SecretKr/NAV-Cansat-2021/Presentation/gui.PNG

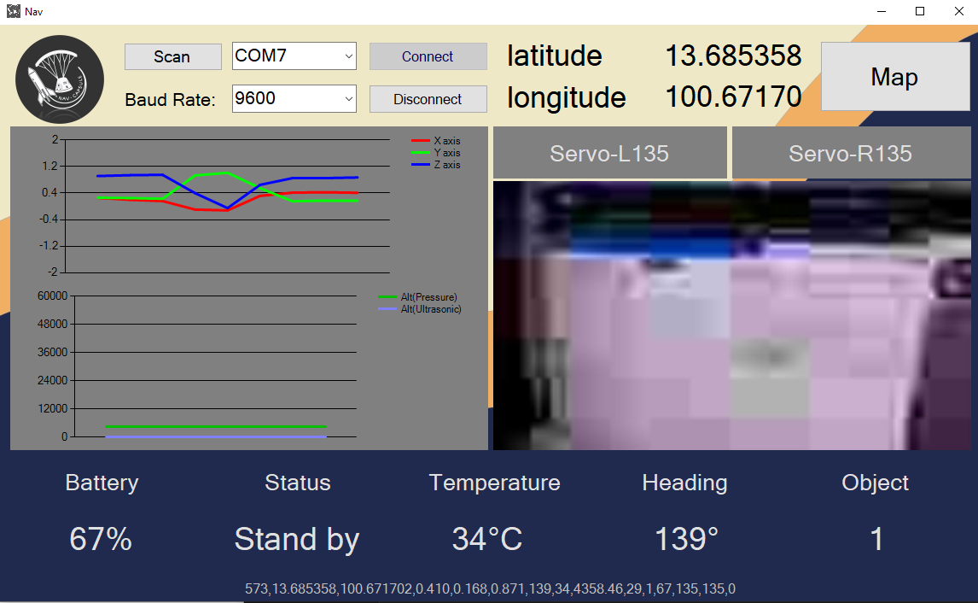
Presentation/gui.PNG
