SecretKr/NAV-Cansat-2021/Cansat/pi install.txt

sudo apt-get update
sudo apt-get upgrade
sudo apt install samba samba-common-bin smbclient cifs-utils
sudo nano /etc/samba/smb.conf
	[pimylifeupshare]
	path = /home/pi/shared
	writeable=Yes
	create mask=0777
	directory mask=0777
	public=no
sudo apt-get install xrdp
