SecretKr/NAV-Cansat-2021/Rocket/test/test1.xlsx

Millis | T | AX | AY | AZ | Vec | ReMPU | wire | Temp | Press | Alt
0 | 0 | 0.91 | -0.32 | -0.35 | 1.03 | 0 | 1 | 35.83 | 1006.09 | 112.9_x0001_" | _x0002__x0010__x0005_Ó_x0001__x0002_!Û_x0004_û_x0005_Ó
0 | 0 | 0.89 | -0.34 | -0.37 | 1.02 | 0 | 0 | 35.83 | 1006.09 | 112.92 | 1.67 | -1.23 | 0.01
0 | 0 | 0.94 | -0.29 | -0.32 | 1.04 | 0 | 1 | 35.83 | 1006.09 | 112.91 | 0.33 | 0.54 | 0.01
0 | 1 | 0.91 | -0.31 | -0.34 | 1.01 | 0 | 1 | 35.83 | 1006.09 | 112.91 | 0.88 | 0.54 | 0.01
0 | 2 | 0.92 | -0.31 | -0.32 | 1.02 | 0 | 1 | 35.83 | 1006.09 | 112.91 | 3.99 | -1.47 | 0.01
0 | 3 | 0.89 | -0.32 | -0.38 | 1.02 | 0 | 1 | 35.83 | 1006.09 | 112.91 | 0.08 | -0.01 | 0.08
0 | 4 | 0.91 | -0.32 | -0.36 | 1.03 | 0 | 1 | 35.83 | 1006.09 | 112.91 | 1.18 | -0.01 | 0.08
0 | 5 | 0.91 | -0.32 | -0.32 | 1.02 | 0 | 1 | 35.83 | 1006.09 | 112.91 | 1 | 0.24 | 0.08
0 | 6 | 0.91 | -0.32 | -0.35 | 1.03 | 0 | 1 | 35.83 | 1006.09 | 112.88 | 0.45 | 0.11 | 0.01
0 | 7 | 0.91 | -0.32 | -0.35 | 1.03 | 0 | 1 | 35.83 | 1006.09 | 112.88 | 0.02 | -0.01 | 0.01
0 | 8 | 0.9 | -0.31 | -0.35 | 1.02 | 0 | 1 | 35.83 | 1006.09 | 112.88 | 2.09 | -0.56 | -0._x0005__x0008_
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
