SecretKr/NAV-Cansat-2021/Rocket/rocket smb.brd

## EAGLE design Rocket/rocket smb.brd (2022-01-02)

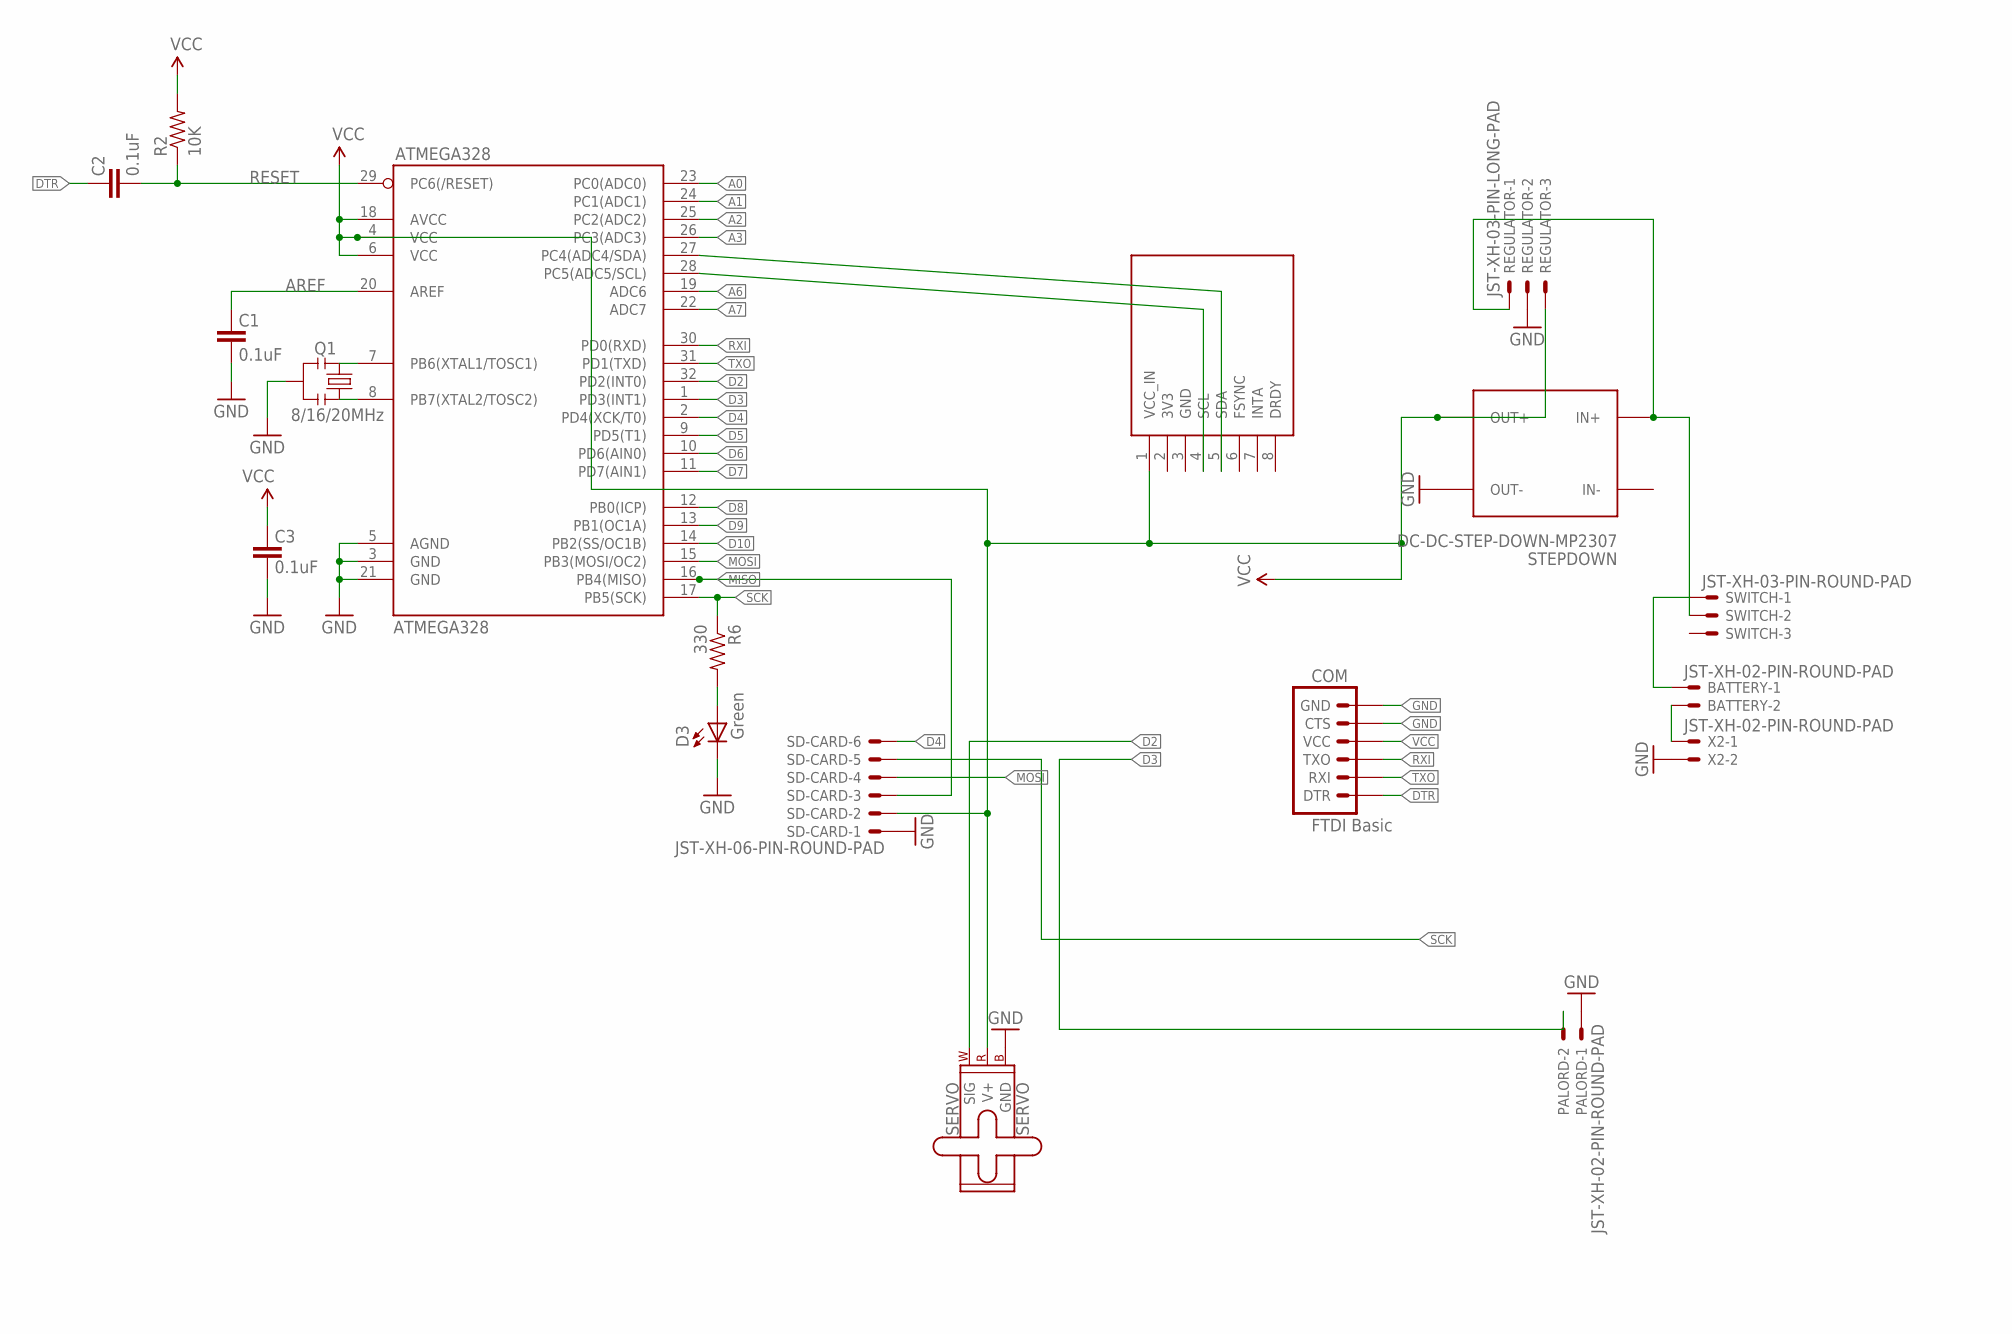
[picture p2: schematic rocket smb.sch]

Parts:
ATMEGA328: ATMEGA328; TQFP32-08
BATTERY: JST-XH-02-PIN-ROUND-PAD; JST-XH-02-PACKAGE-ROUND-PAD
C1, C2, C3: 0.1uF; 0603-CAP
COM: FTDI Basic; 1X06
D3: Green; 0603-LED-ALT1
MPU: GY-86
PALORD: JST-XH-02-PIN-ROUND-PAD; JST-XH-02-PACKAGE-ROUND-PAD
Q1: 8/16/20MHz; RESONATOR-SMD-1:1
R2: 10K; 0603-RES
R6: 330; 0603-RES
REGULATOR: JST-XH-03-PIN-LONG-PAD; JST-XH-03-PACKAGE-LONG-PAD
SD-CARD: JST-XH-06-PIN-ROUND-PAD; JST-XH-06-PACKAGE-ROUND-PAD
SERVO: SERVO; 1X03
STEPDOWN: DC-DC-STEP-DOWN-MP2307
SWITCH: JST-XH-03-PIN-ROUND-PAD; JST-XH-03-PACKAGE-ROUND-PAD
X2: JST-XH-02-PIN-ROUND-PAD; JST-XH-02-PACKAGE-ROUND-PAD

Connections:
A0: ATMEGA328.23 (PC0(ADC0))
A1: ATMEGA328.24 (PC1(ADC1))
A2: ATMEGA328.25 (PC2(ADC2))
A3: ATMEGA328.26 (PC3(ADC3))
A6: ATMEGA328.19 (ADC6)
A7: ATMEGA328.22 (ADC7)
AREF: ATMEGA328.20 (AREF), C1.2
D2: ATMEGA328.32 (PD2(INT0)), SERVO.1 (SIG)
D3: ATMEGA328.1 (PD3(INT1)), PALORD.2
D4: ATMEGA328.2 (PD4(XCK/T0)), SD-CARD.6
D5: ATMEGA328.9 (PD5(T1))
D6: ATMEGA328.10 (PD6(AIN0))
D7: ATMEGA328.11 (PD7(AIN1))
D8: ATMEGA328.12 (PB0(ICP))
D9: ATMEGA328.13 (PB1(OC1A))
D10: ATMEGA328.14 (PB2(SS/OC1B))
DTR: C2.2, COM.1 (DTR)
GND: ATMEGA328.3 (GND), ATMEGA328.5 (AGND), ATMEGA328.21 (GND), C1.1, C3.1, COM.5 (CTS), COM.6 (GND), D3.C, MPU.3 (GND), PALORD.1, Q1.2, REGULATOR.2, SD-CARD.1, SERVO.3 (GND), STEPDOWN.OUT-, X2.2
MISO: ATMEGA328.16 (PB4(MISO)), SD-CARD.3
MOSI: ATMEGA328.15 (PB3(MOSI/OC2)), SD-CARD.4
unnamed: BATTERY.2, X2.1
unnamed: BATTERY.1, SWITCH.1
unnamed: REGULATOR.1, STEPDOWN.IN+, SWITCH.2
unnamed: ATMEGA328.28 (PC5(ADC5/SCL)), MPU.4 (SCL)
unnamed: ATMEGA328.27 (PC4(ADC4/SDA)), MPU.5 (SDA)
unnamed: D3.A, R6.2
unnamed: ATMEGA328.8 (PB7(XTAL2/TOSC2)), Q1.3
unnamed: ATMEGA328.7 (PB6(XTAL1/TOSC1)), Q1.1
RESET: ATMEGA328.29 (PC6(/RESET)), C2.1, R2.1
RXI: ATMEGA328.30 (PD0(RXD)), COM.3 (TXO)
SCK: ATMEGA328.17 (PB5(SCK)), R6.1, SD-CARD.5
TXO: ATMEGA328.31 (PD1(TXD)), COM.2 (RXI)
VCC: ATMEGA328.4 (VCC), ATMEGA328.6 (VCC), ATMEGA328.18 (AVCC), C3.2, COM.4 (VCC), MPU.1 (VCC_IN), R2.2, REGULATOR.3, SD-CARD.2, SERVO.2 (V+), STEPDOWN.OUT+

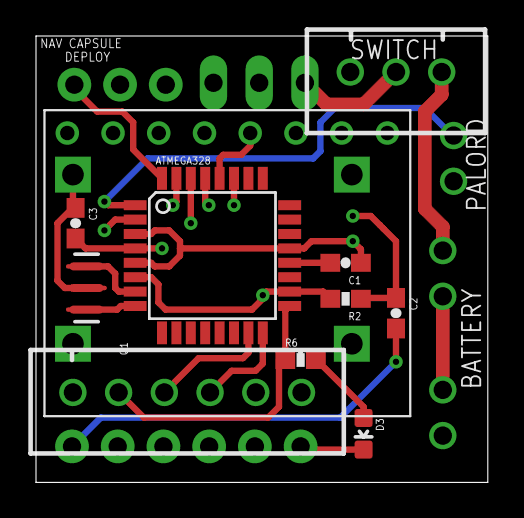
[picture p3: board rocket smb.brd from above]

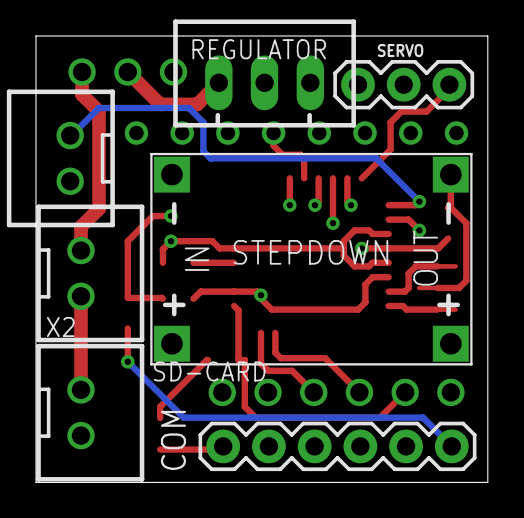
[picture p4: board rocket smb.brd from below]

Board: 4 copper layers, 25.1 x 24.8 mm, 18 parts (7 on the bottom side), 21 nets.
