SecretKr/NAV-Cansat-2021/Cansat/PCB/cansat.brd

## EAGLE design Cansat/PCB/cansat.brd (2022-01-02)

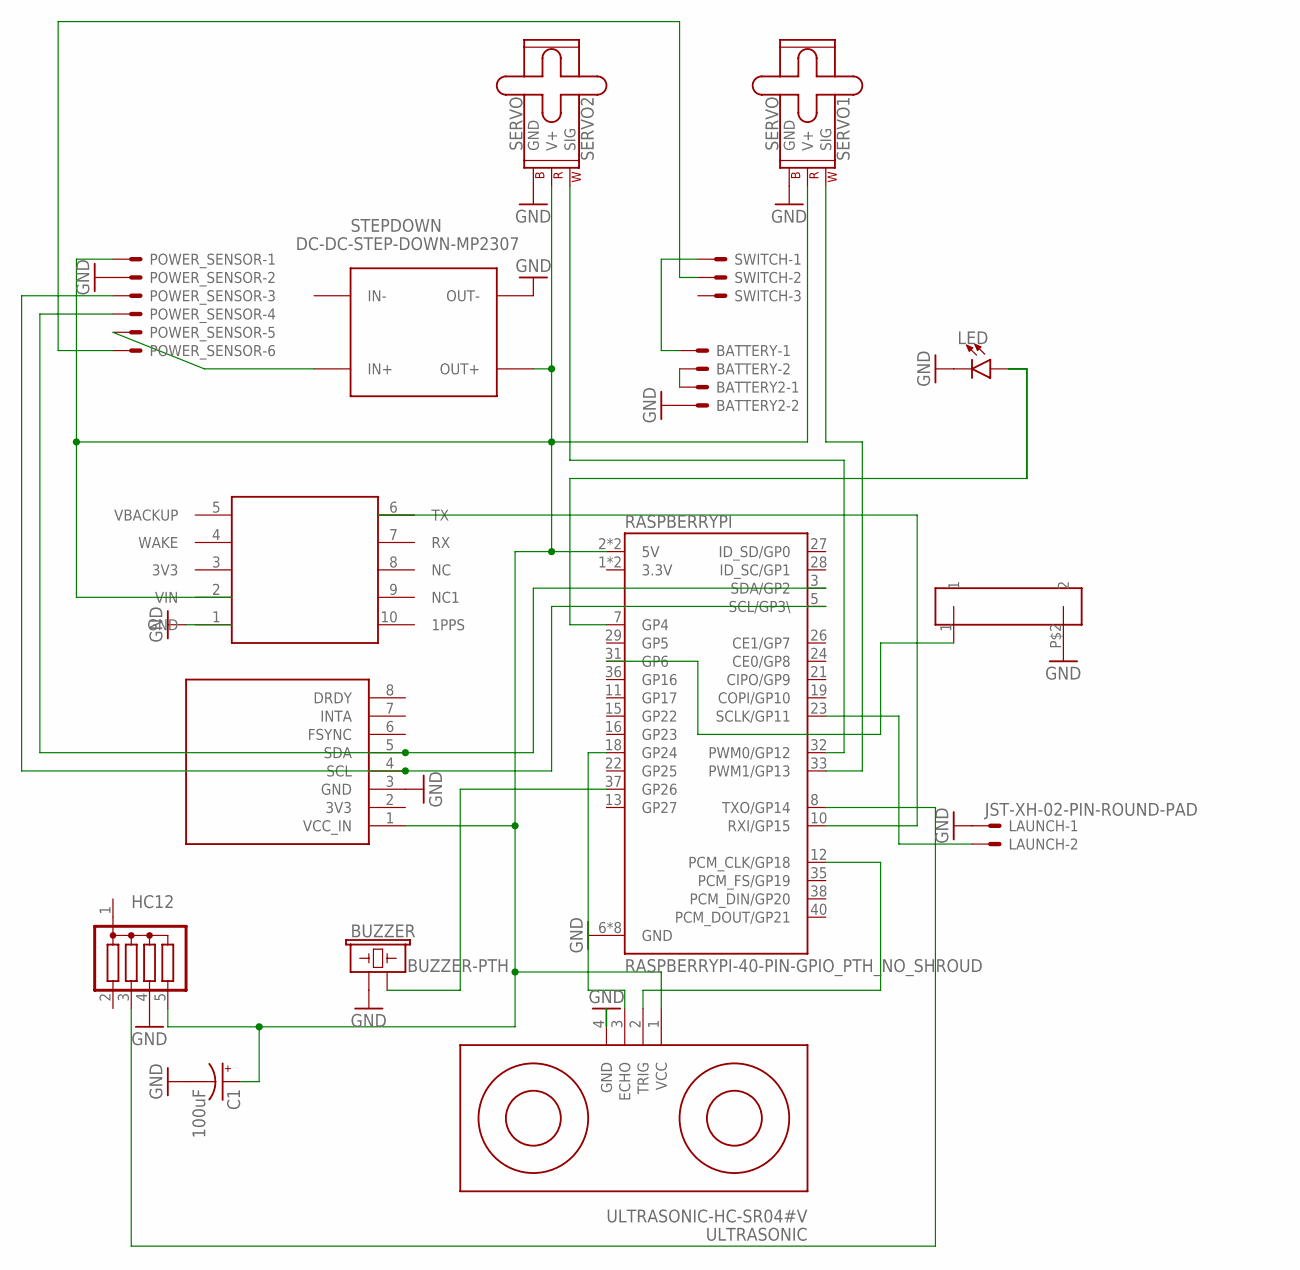
[picture p5: schematic cansat.sch]

Parts:
BATTERY, BATTERY2: JST-XH-02-PIN-ROUND-PAD; JST-XH-02-PACKAGE-ROUND-PAD
BUZZER: BUZZER-PTH; BUZZER-12MM
C1: 100uF; CPOL-RADIAL-2.5MM-6.5MM
GPS: AIR530; AIR530FOOTPRINT
HC12: G04R; SIL5
LAUNCH: JST-XH-02-PIN-ROUND-PAD; JST-XH-02-PACKAGE-ROUND-PAD
LED: LED5MM; LED_5MM
MPU: GY-86
POWER_SENSOR: JST-XH-06-PIN-ROUND-PAD; JST-XH-06-PACKAGE-ROUND-PAD
RASPBERRYPI: RASPBERRYPI-40-PIN-GPIO_PTH_NO_SHROUD; 2X20
SENSOR: PENCIL
SERVO1, SERVO2: SERVO; 1X03
STEPDOWN: DC-DC-STEP-DOWN-MP2307
SWITCH: JST-XH-03-PIN-ROUND-PAD; JST-XH-03-PACKAGE-ROUND-PAD
ULTRASONIC: ULTRASONIC-HC-SR04#V

Connections:
3.3V: RASPBERRYPI.1 (3.3V), RASPBERRYPI.17 (3.3V)
GND: BATTERY2.2, BUZZER.+ (1), C1.2 (-), GPS.1 (GND), HC12.4, LAUNCH.1, LED.K (C), MPU.3 (GND), POWER_SENSOR.2, RASPBERRYPI.6 (GND), RASPBERRYPI.9 (GND), RASPBERRYPI.14 (GND), RASPBERRYPI.20 (GND), RASPBERRYPI.25 (GND), RASPBERRYPI.30 (GND), RASPBERRYPI.34 (GND), RASPBERRYPI.39 (GND), SENSOR.P$2 (2), SERVO1.3 (GND), SERVO2.3 (GND), STEPDOWN.OUT-, ULTRASONIC.4 (GND)
unnamed: C1.1 (+), GPS.2 (VIN), HC12.5, MPU.1 (VCC_IN), POWER_SENSOR.1, RASPBERRYPI.2 (5V), RASPBERRYPI.4 (5V), SERVO1.2 (V+), SERVO2.2 (V+), STEPDOWN.OUT+, ULTRASONIC.1 (VCC)
unnamed: LED.A, RASPBERRYPI.7 (GP4)
unnamed: BATTERY.2, BATTERY2.1
unnamed: BATTERY.1, SWITCH.1
unnamed: POWER_SENSOR.6, SWITCH.2
unnamed: GPS.6 (TX), RASPBERRYPI.10 (RXI/GP15)
unnamed: HC12.3, RASPBERRYPI.8 (TXO/GP14)
unnamed: MPU.5 (SDA), POWER_SENSOR.4, RASPBERRYPI.3 (SDA/GP2)
unnamed: MPU.4 (SCL), POWER_SENSOR.3, RASPBERRYPI.5 (SCL/GP3\)
unnamed: RASPBERRYPI.12 (PCM_CLK/GP18), ULTRASONIC.2 (TRIG)
unnamed: RASPBERRYPI.18 (GP24), ULTRASONIC.3 (ECHO)
unnamed: RASPBERRYPI.32 (PWM0/GP12), SERVO2.1 (SIG)
unnamed: RASPBERRYPI.33 (PWM1/GP13), SERVO1.1 (SIG)
unnamed: BUZZER.- (2), RASPBERRYPI.37 (GP26)
unnamed: LAUNCH.2, RASPBERRYPI.23 (SCLK/GP11)
unnamed: POWER_SENSOR.5, STEPDOWN.IN+
unnamed: RASPBERRYPI.31 (GP6), SENSOR.1

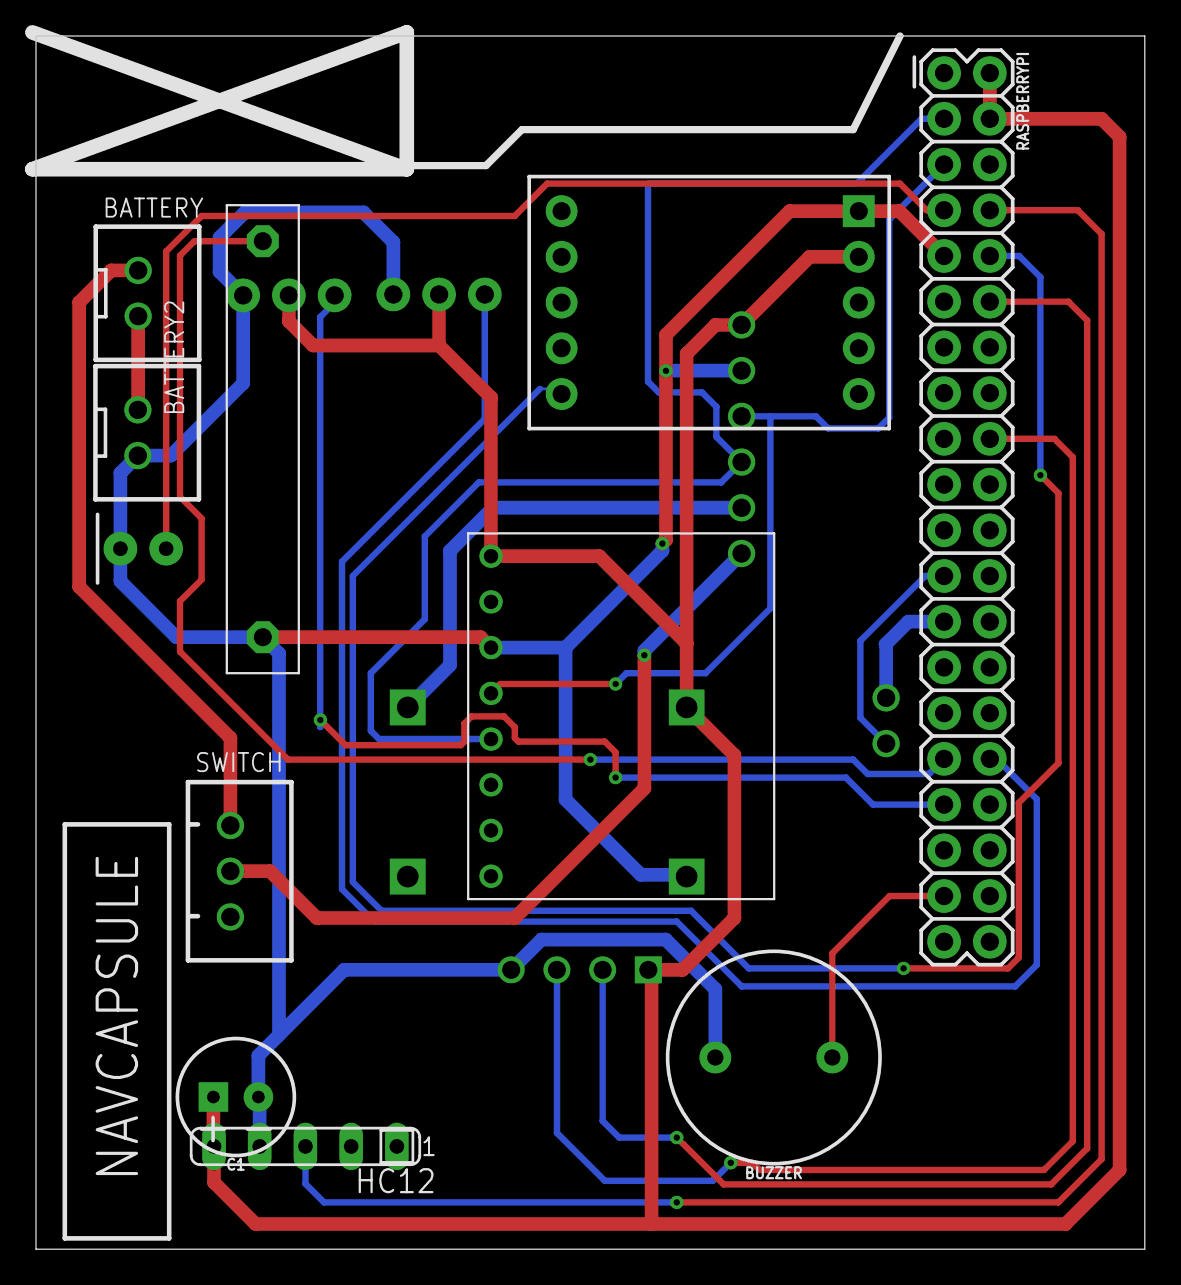
[picture p6: board cansat.brd from above]

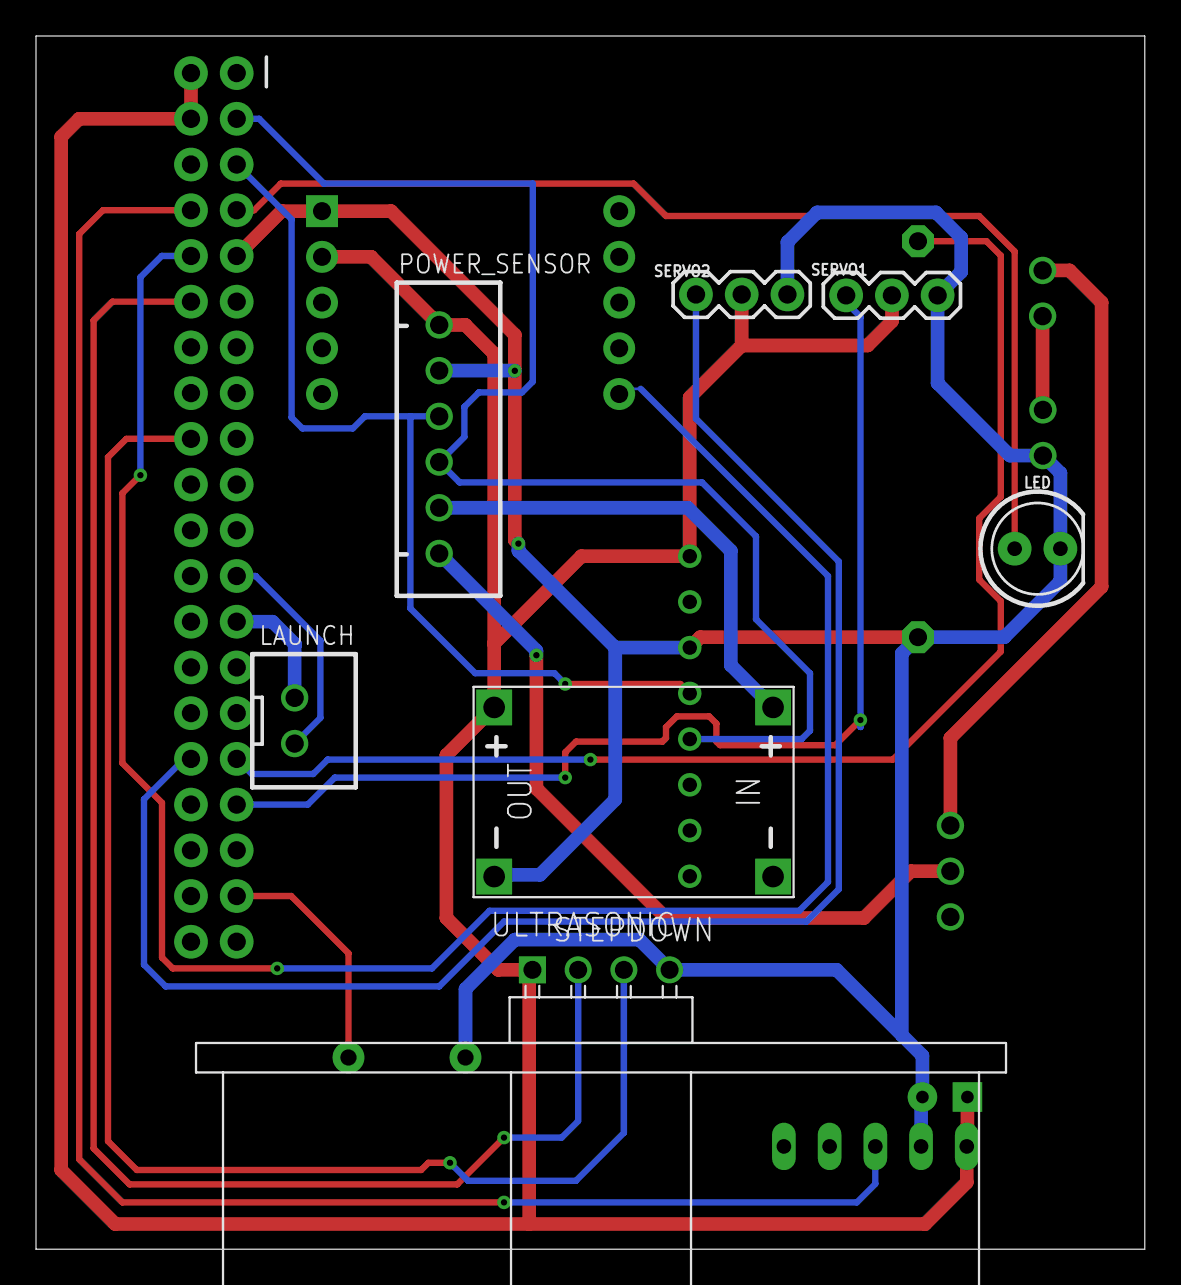
[picture p7: board cansat.brd from below]

Board: 2 copper layers, 61.6 x 67.4 mm, 17 parts (7 on the bottom side), 19 nets.
