SecretKr/NAV-Cansat-2021/Ground station/test/test.ino

const int trigPin = 9;
const int echoPin = 8;

long duration;
int distance;
float t = 0;
void setup() {
pinMode(trigPin, OUTPUT); // Sets the trigPin as an Output
pinMode(echoPin, INPUT); // Sets the echoPin as an Input
Serial.begin(9600); // Starts the serial communication
}
void loop() {
digitalWrite(trigPin, LOW);
delayMicroseconds(2);
digitalWrite(trigPin, HIGH);
delayMicroseconds(10);
digitalWrite(trigPin, LOW);
// Reads the echoPin, returns the sound wave travel time in microseconds
duration = pulseIn(echoPin, HIGH);
// Calculating the distance
distance= duration*0.034/2;
Serial.print(t);
Serial.print(",");
Serial.println(distance);
delay(100);
t += 0.1;
}
